ajayre/JacktheRipperBot/Documents/Renders/Toolhead-Exploded.png

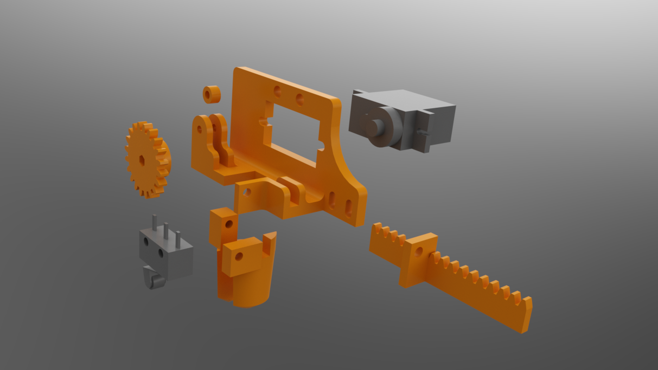
Documents/Renders/Toolhead-Exploded.png
