ajayre/JacktheRipperBot/Documents/Renders/Core-Exploded.png

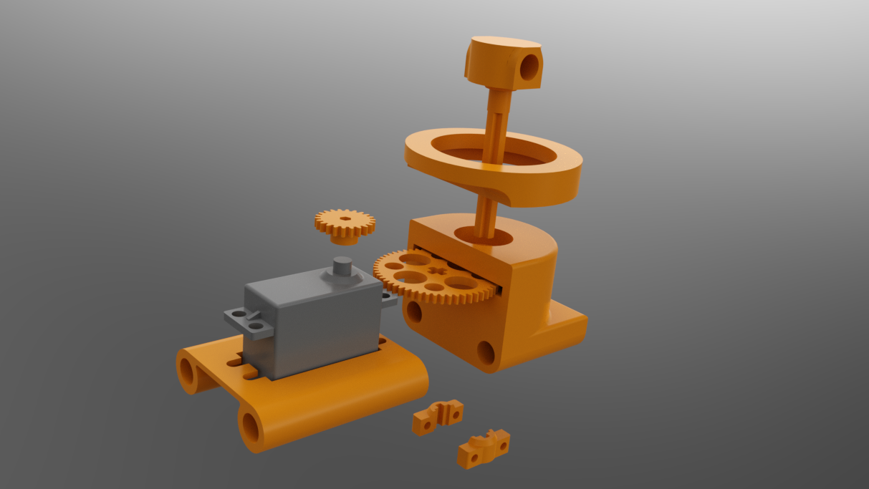
Documents/Renders/Core-Exploded.png
