ajayre/JacktheRipperBot/README.md

JackTheRipperBot
================

3D printable DVD ripping robot
