ajayre/JacktheRipperBot/Documents/BlockDiagram.png

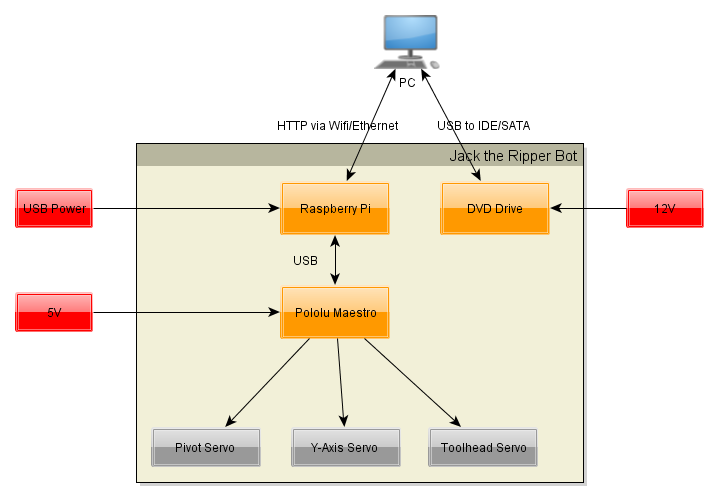
Documents/BlockDiagram.png
