ajayre/JacktheRipperBot/Documents/CircuitDiagram.png

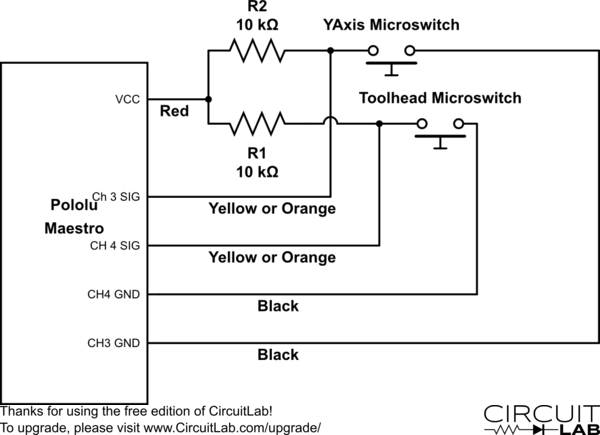
Documents/CircuitDiagram.png
