ajayre/JacktheRipperBot/Documents/MechanicsBlockDiagram.png

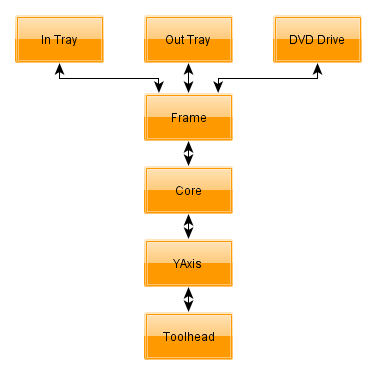
Documents/MechanicsBlockDiagram.png
