ajayre/JacktheRipperBot/Documents/Renders/Frame-Exploded.png

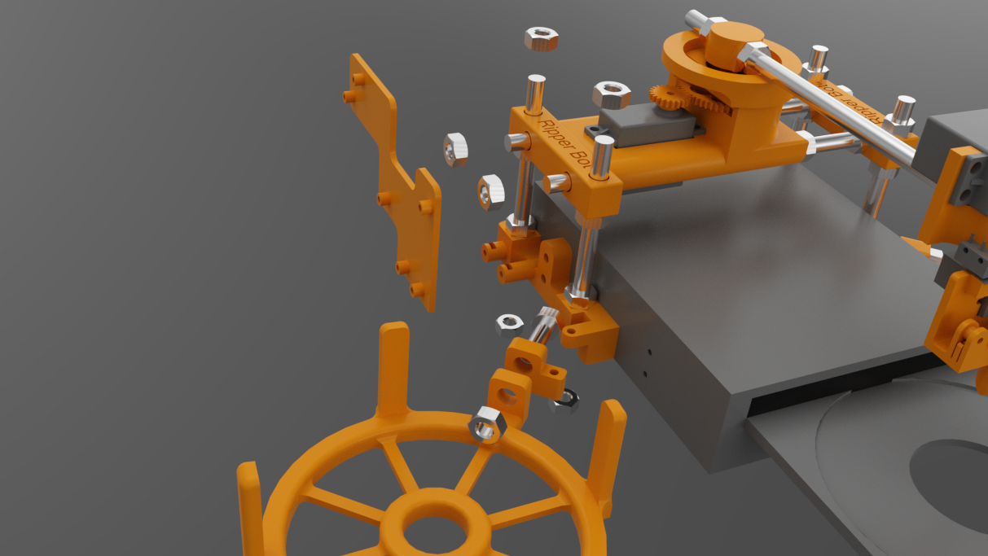
Documents/Renders/Frame-Exploded.png
