ajayre/JacktheRipperBot/Documents/Renders/JacktheRipperBot.png

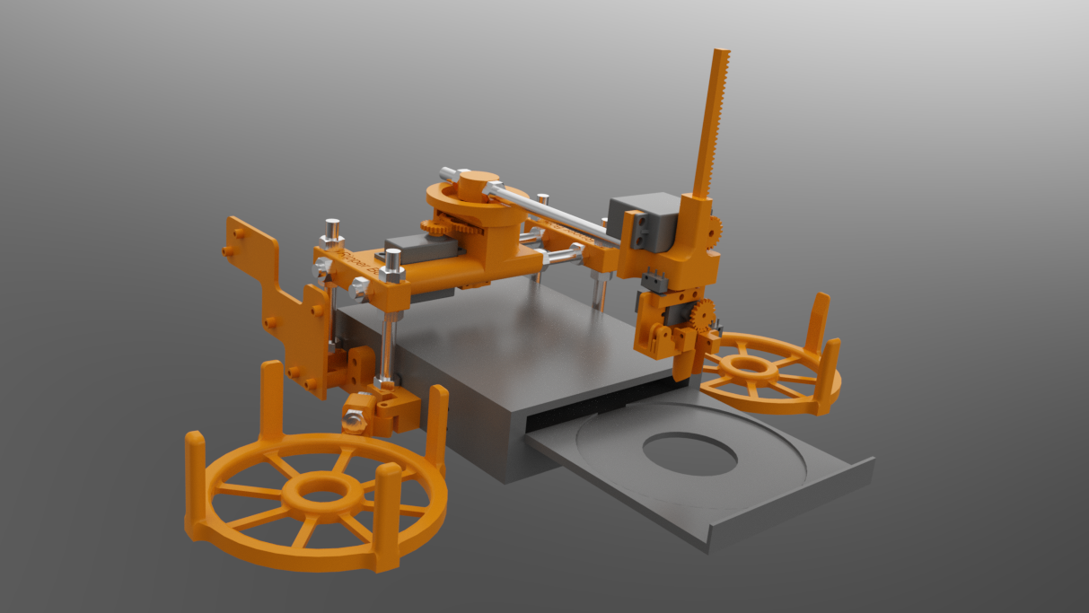
Documents/Renders/JacktheRipperBot.png
