ajayre/JacktheRipperBot/Documents/Renders/Tray-Exploded.png

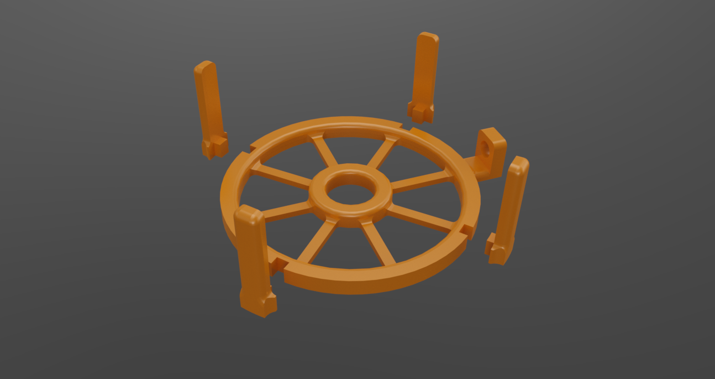
Documents/Renders/Tray-Exploded.png
