ajayre/JacktheRipperBot/Documents/Renders/YAxis-Exploded.png

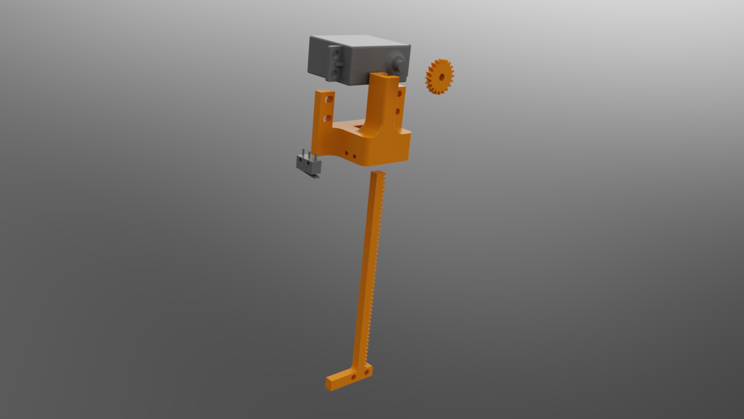
Documents/Renders/YAxis-Exploded.png
