ajayre/JacktheRipperBot/Documents/BillofMaterials.xlsx

Jack the Ripper Bot
Bill of Materials
Quantity | Description | Notes | Source2
1 | M8 threaded rod, 220mm long
2 | M8 threaded rod, 200mm long
4 | M8 threaded rod, 100mm long
2 | M8 threaded rod, 30mm long
32 | M8 nuts
27 | M8 lock nuts
1 | Futaba S3003 servo or equivalent | Modify for continuous rotation | http://www.techsupplies.co.uk/epages/Store.sf/en_GB/
1 | GWS S125 1T 2BB Sail Winch servo
1 | 9g minature servo |  | http://www.techsupplies.co.uk/epages/Store.sf/en_GB/
1 | Roller microswitch |  | http://www.rapidonline.com/Electronic-Components/Cherry-DG23-B1RA-Microswitch-SPST-On-On-50-2654
1 | Lever microswitch |  | http://www.rapidonline.com/Electronic-Components/Cherry-DG23-B1LA-Microswitch-SPST-On-On-50-2653
1 | Raspberry Pi Model B
1 | Pololu Maestro 6-channel servo controller |  | http://www.hobbytronics.co.uk/pololu-servo-controller-6
1 | 4GB+ SD card | For Raspberry Pi
1 | USB power cable | For Raspberry Pi
1 | DVD drive | Internal 5.25"
4 | Servo extension cables |  | http://www.ebay.co.uk/itm/280753277454?ssPageName=STRK:MEWNX:IT&_trksid=p3984.m1439.l2649
1 | USB cable | Connecting Maestro to Raspberry Pi
1 | Ethernet cable or N150 wifi adapter | Internet connectivity for Raspberry Pi | http://www.hobbytronics.co.uk/raspberry-pi/usb-wifi-adapter
1 | IDE/SATA to USB adapter | For the DVD drive | http://www.amazon.co.uk/dp/B004ND4632/ref=pe_385721_37038051_pe_217191_31005151_3p_M3T1_dp_1
2 | 608ZZ Bearing
18 | M3 nuts
11 | M2 nuts
4 | M3 socket cap, 12mm
14 | M3 socket cap, 14mm
2 | M3 socket cap, 16mm
2 | M3 socket cap, 18mm
7 | M2 socket cap, 10mm
4 | M2 socket cap, 14mm
8 | M3 washers
2 | 10kOhm resistor
1 | 0.1 inch crimp terminals
1 | 2 way 0.1 inch molex connector
1 | 2 pin PCB header
