ajayre/JacktheRipperBot/Parts/STEP/MainGear.stp

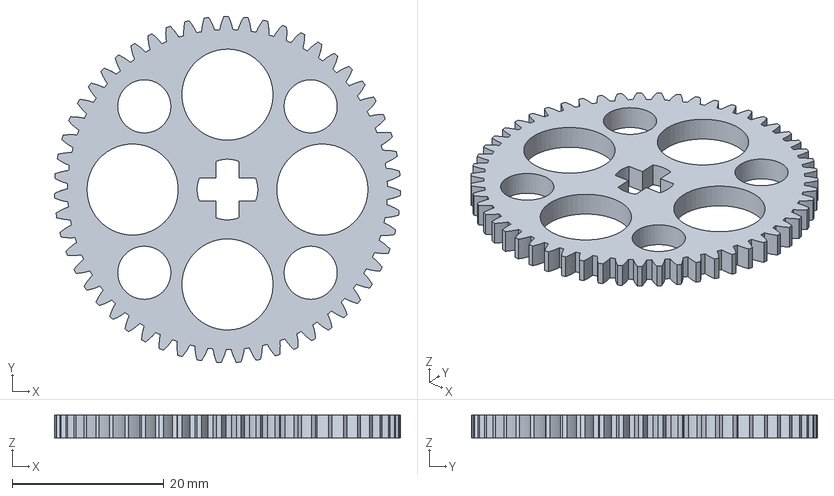
[picture p10: CAD file, 2013-10-11]
Parts/STEP/MainGear.stp
45.6 x 45.6 x 3.00 mm
