ajayre/JacktheRipperBot/Parts/STEP/YAxis-Servo.stp

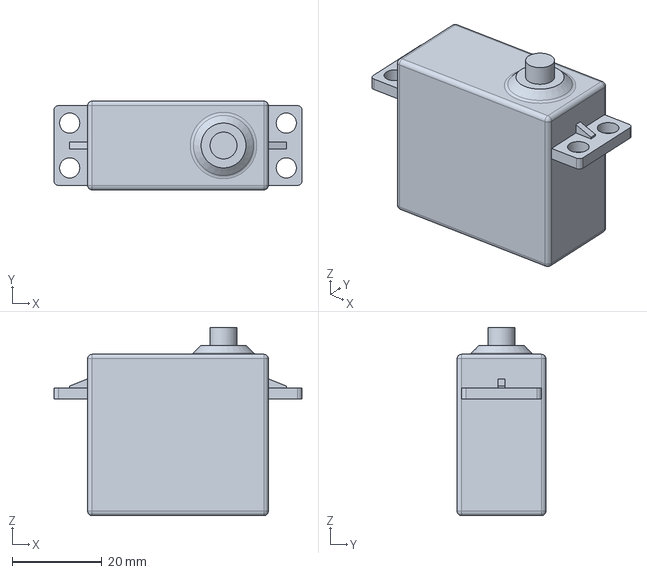
[picture p11: CAD file, 2016-06-15]
Parts/STEP/YAxis-Servo.stp
55.3 x 19.8 x 42.0 mm
