ajayre/JacktheRipperBot/Parts/STLs/JacktheRipperBot-OutTrayArm-1_X4.stl

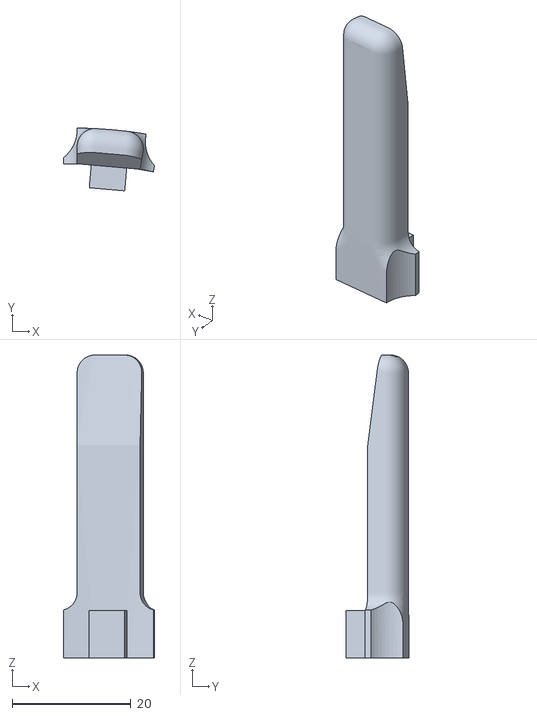
[picture p12: CAD file, 2013-09-24]
Parts/STLs/JacktheRipperBot-OutTrayArm-1_X4.stl
15.4 x 10.6 x 51.0
