ajayre/JacktheRipperBot/Parts/STEP/Toolhead-Microswitch.stp

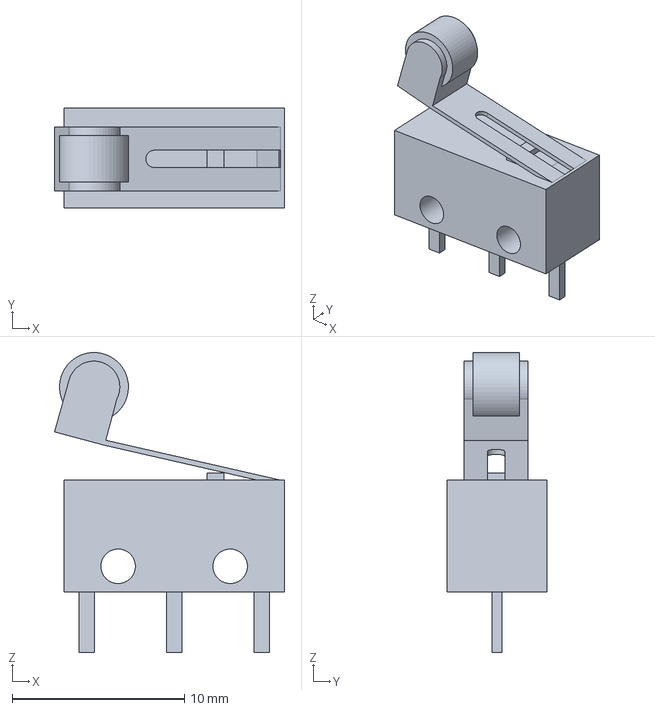
[picture p13: CAD file, 2016-06-15]
Parts/STEP/Toolhead-Microswitch.stp
13.3 x 5.80 x 17.4 mm
