ajayre/JacktheRipperBot/Parts/STLs/JacktheRipperBot-TrayBase-1_X2.stl

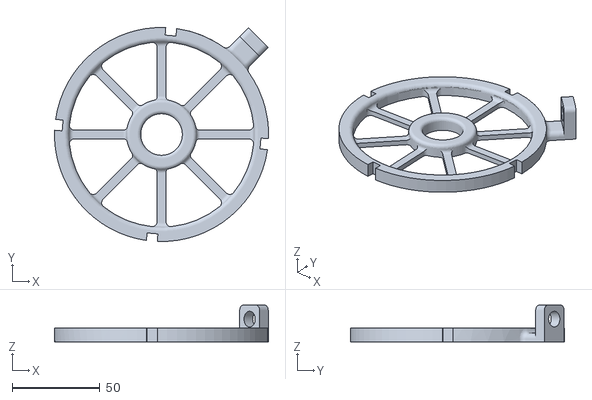
[picture p14: CAD file, 2013-09-24]
Parts/STLs/JacktheRipperBot-TrayBase-1_X2.stl
122.0 x 121.9 x 21.0
