ajayre/JacktheRipperBot/Parts/STEP/Drive.stp

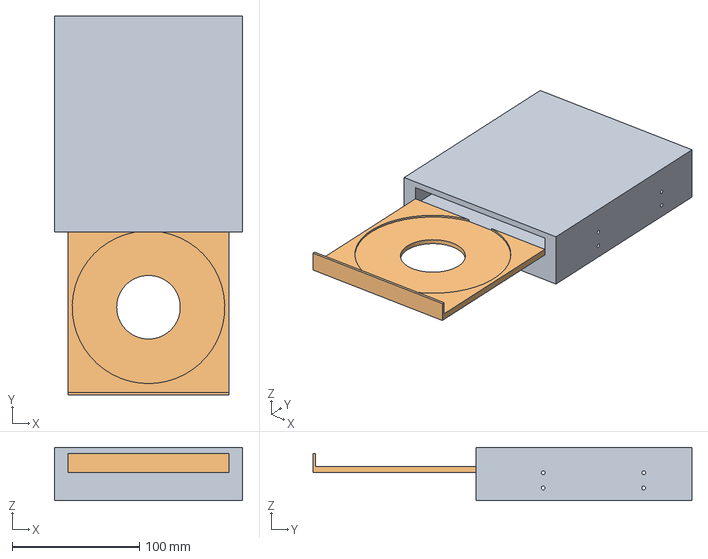
[picture p15: CAD file, 2016-06-15]
Parts/STEP/Drive.stp
148.2 x 298.0 x 42.0 mm
