ajayre/JacktheRipperBot/Parts/STLs/JacktheRipperBot-YAxis-1-YAxis-1.stl

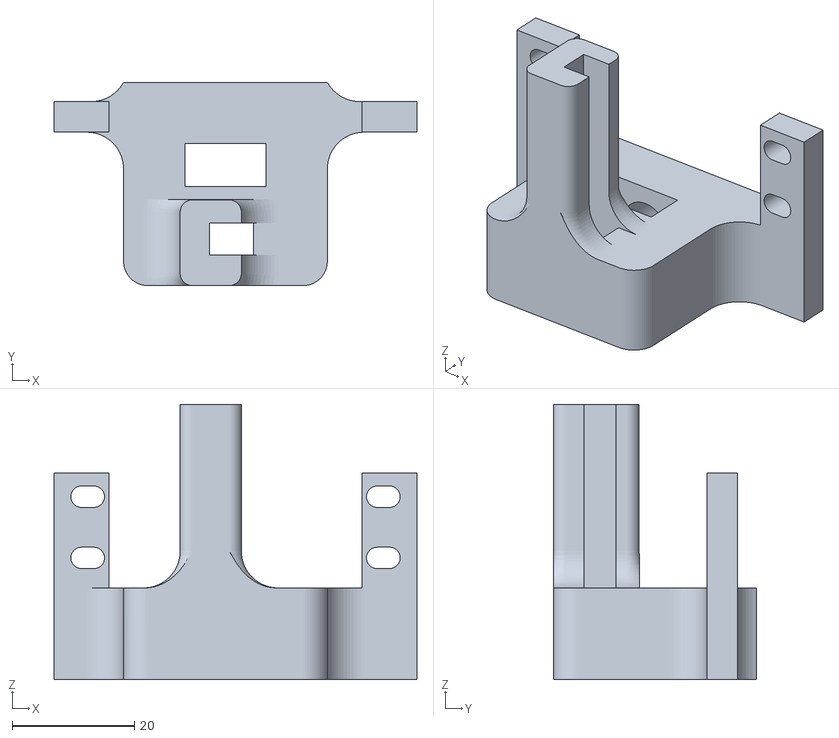
[picture p16: CAD file, 2013-09-20]
Parts/STLs/JacktheRipperBot-YAxis-1-YAxis-1.stl
59.3 x 33.2 x 45.0
