ajayre/JacktheRipperBot/Parts/STEP/Toolhead-Servo.stp

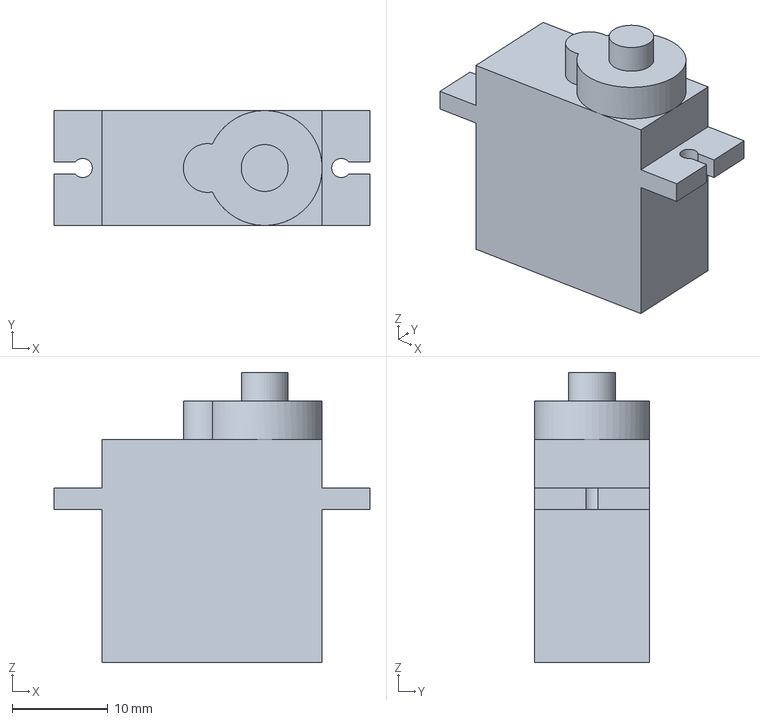
[picture p17: CAD file, 2016-06-15]
Parts/STEP/Toolhead-Servo.stp
33.0 x 12.0 x 30.3 mm
