ajayre/JacktheRipperBot/Parts/STLs/JacktheRipperBot-Core-1-Hub-1.stl

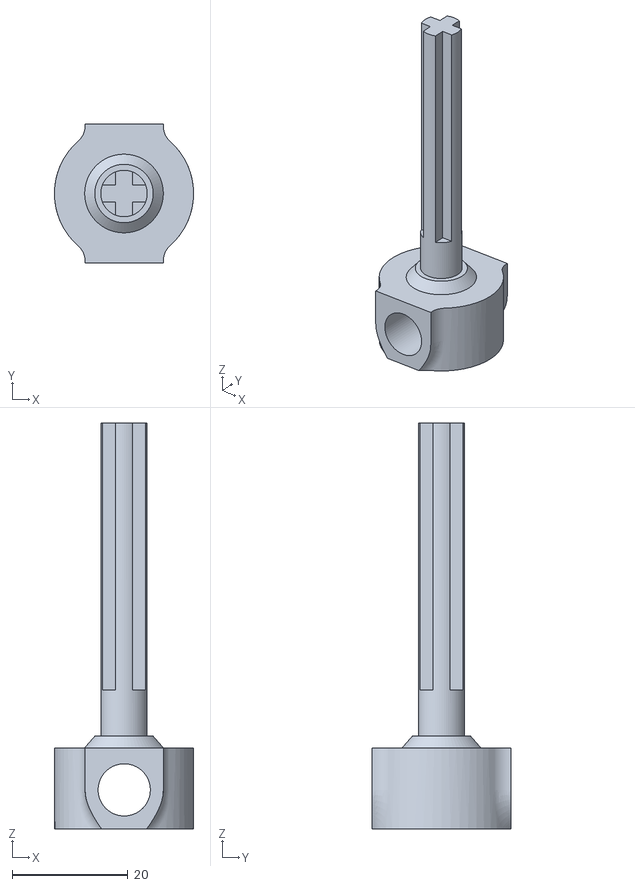
[picture p18: CAD file, 2013-09-07]
Parts/STLs/JacktheRipperBot-Core-1-Hub-1.stl
24.0 x 24.0 x 70.0
