ajayre/JacktheRipperBot/Parts/STEP/YAxis-Microswitch.stp

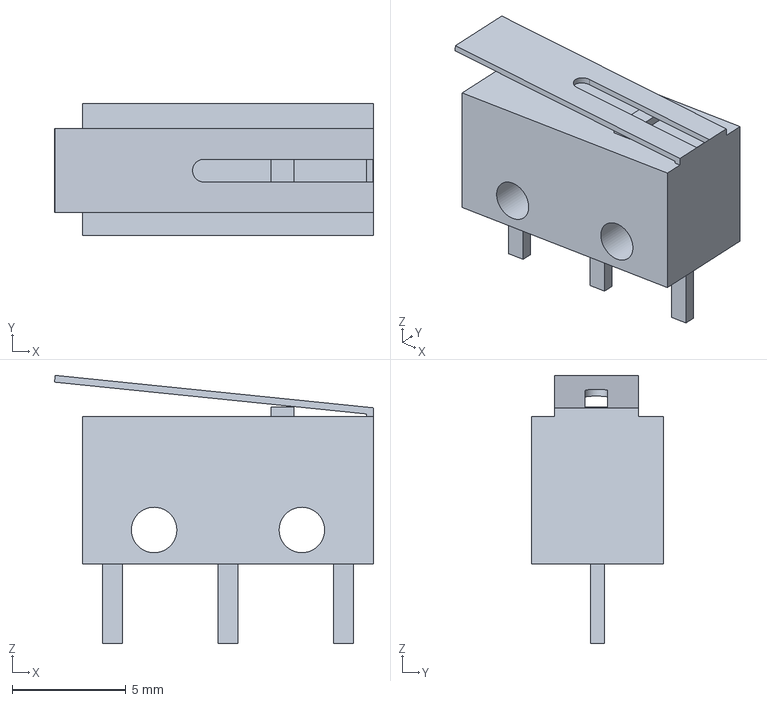
[picture p19: CAD file, 2016-06-15]
Parts/STEP/YAxis-Microswitch.stp
14.0 x 5.80 x 11.8 mm
