ajayre/JacktheRipperBot/Parts/STLs/JacktheRipperBot-Core-1-Retainer-1_X2.stl

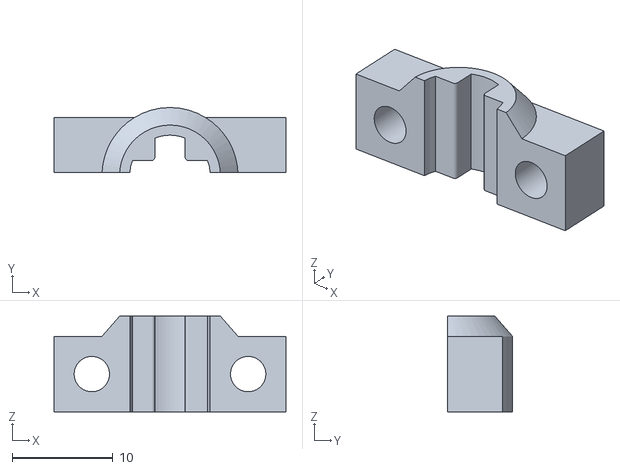
[picture p20: CAD file, 2013-09-07]
Parts/STLs/JacktheRipperBot-Core-1-Retainer-1_X2.stl
23.0 x 6.45 x 9.50
