ajayre/JacktheRipperBot/Parts/STLs/JacktheRipperBot-DriveBracketL-1.stl

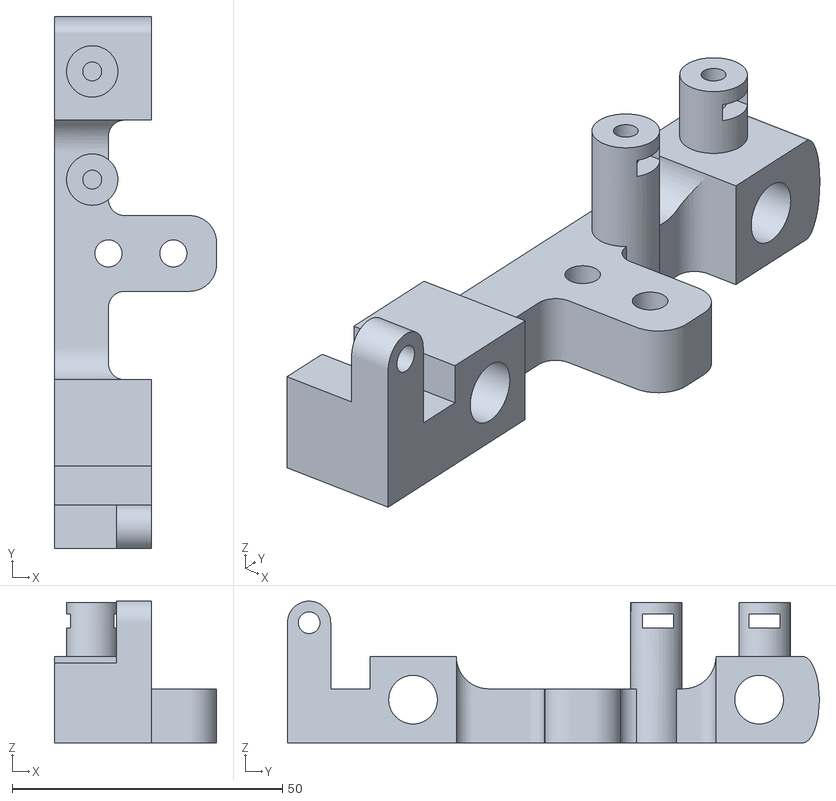
[picture p21: CAD file, 2013-09-01]
Parts/STLs/JacktheRipperBot-DriveBracketL-1.stl
30.0 x 98.4 x 26.2
