ajayre/JacktheRipperBot/Parts/STLs/JacktheRipperBot-TrayAnchor-1_X2.stl

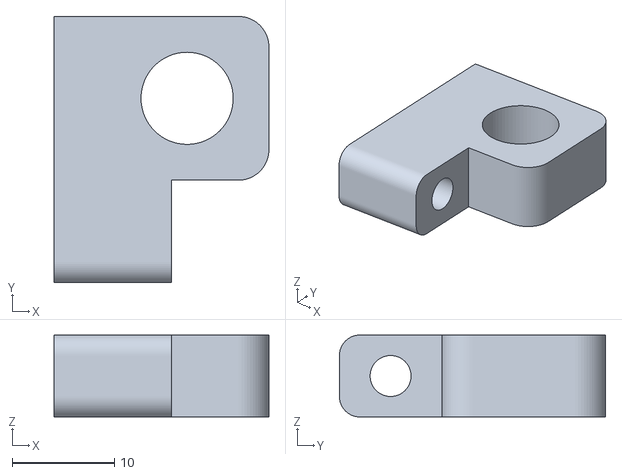
[picture p22: CAD file, 2013-09-01]
Parts/STLs/JacktheRipperBot-TrayAnchor-1_X2.stl
21.0 x 26.0 x 8.00
