ajayre/JacktheRipperBot/Parts/STEP/GripperMoving.stp

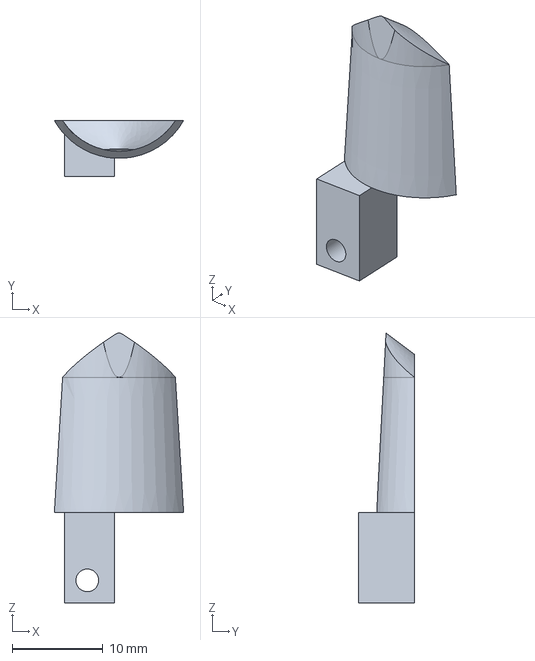
[picture p23: CAD file, 2013-10-11]
Parts/STEP/GripperMoving.stp
14.3 x 6.18 x 29.8 mm
