ajayre/JacktheRipperBot/Parts/STLs/JacktheRipperBot-Core-1-GearHousing-1.stl

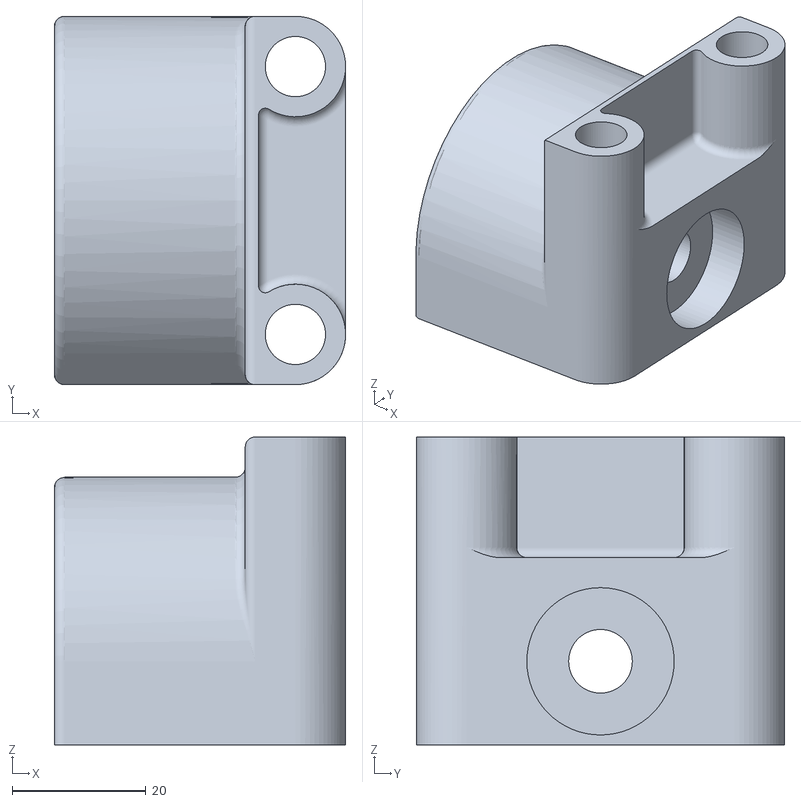
[picture p24: CAD file, 2013-09-01]
Parts/STLs/JacktheRipperBot-Core-1-GearHousing-1.stl
43.5 x 55.0 x 46.0
