ajayre/JacktheRipperBot/Parts/STLs/JacktheRipperBot-Toolhead-1-GripperFixed-1.stl

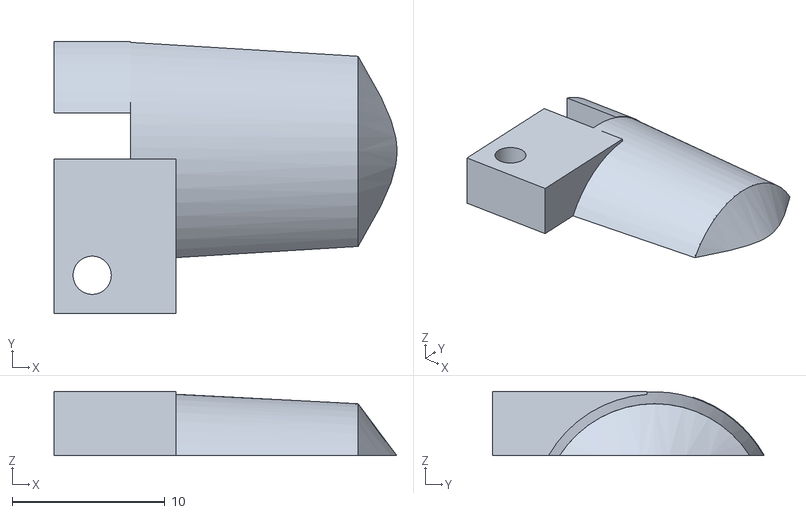
[picture p25: CAD file, 2013-09-01]
Parts/STLs/JacktheRipperBot-Toolhead-1-GripperFixed-1.stl
22.5 x 17.8 x 4.21
