ajayre/JacktheRipperBot/Parts/STEP/ElectronicsCaddy.stp

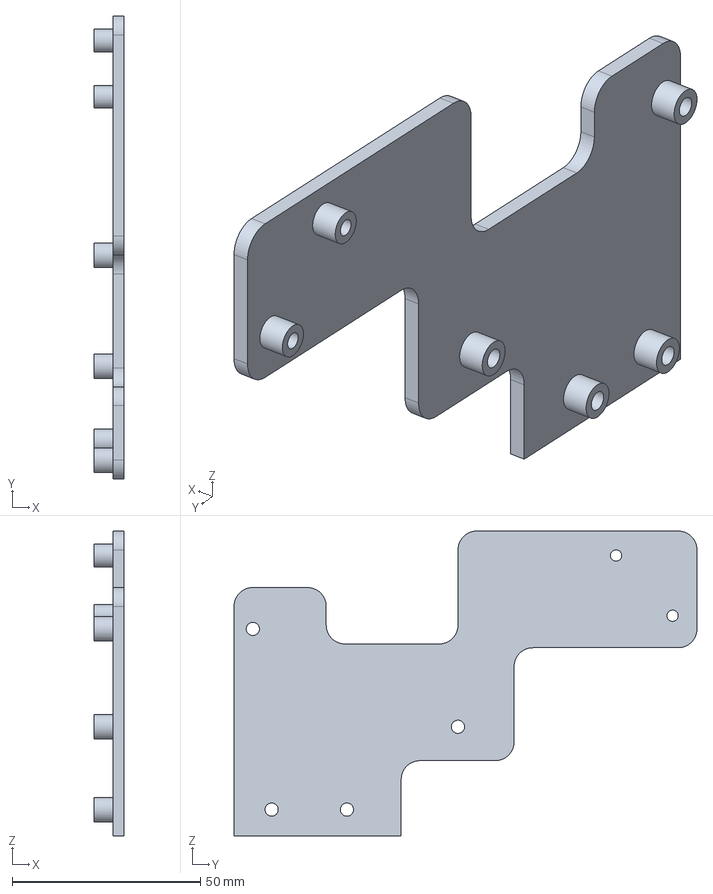
[picture p26: CAD file, 2013-10-11]
Parts/STEP/ElectronicsCaddy.stp
8.00 x 123.0 x 81.0 mm
