ajayre/JacktheRipperBot/Parts/STLs/JacktheRipperBot-YAxis-1-Rod-1.stl

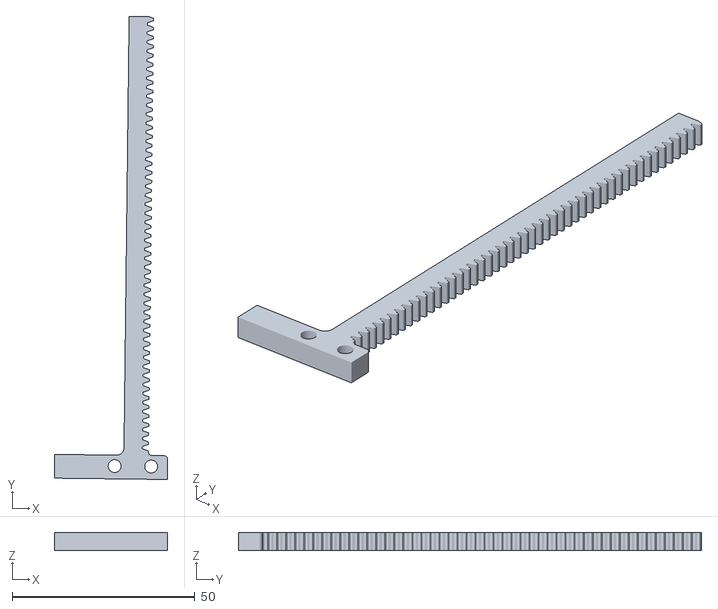
[picture p27: CAD file, 2013-09-01]
Parts/STLs/JacktheRipperBot-YAxis-1-Rod-1.stl
31.0 x 126.6 x 5.00
