ajayre/JacktheRipperBot/Parts/STEP/YAxis-ServoGear.stp

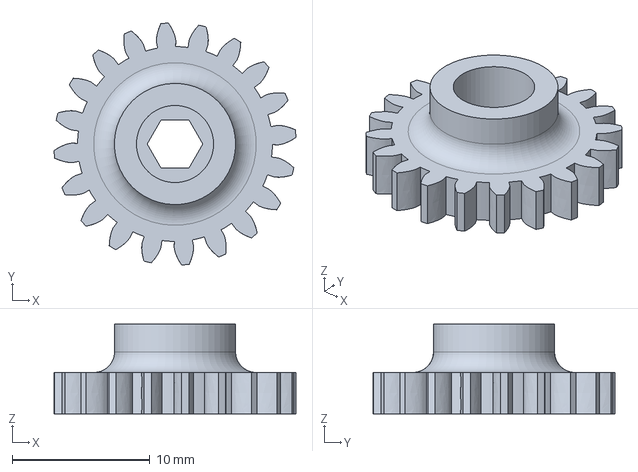
[picture p28: CAD file, 2013-10-11]
Parts/STEP/YAxis-ServoGear.stp
17.6 x 17.6 x 6.50 mm
