ajayre/JacktheRipperBot/Parts/STEP/Frame.stp

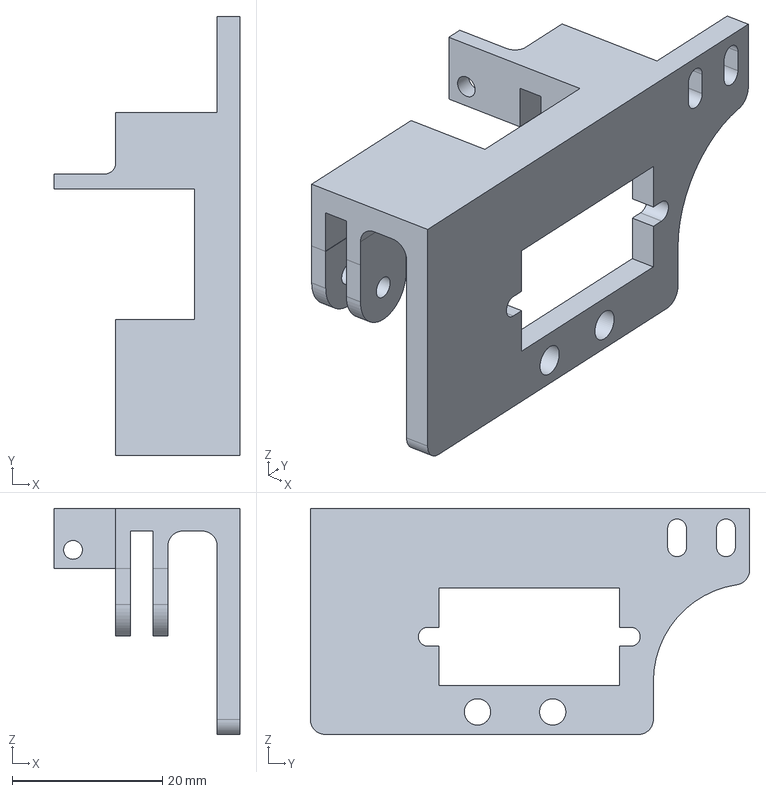
[picture p29: CAD file, 2013-10-11]
Parts/STEP/Frame.stp
24.7 x 58.4 x 30.0 mm
