ajayre/JacktheRipperBot/Parts/STLs/JacktheRipperBot-Toolhead-1-Guide-1.stl

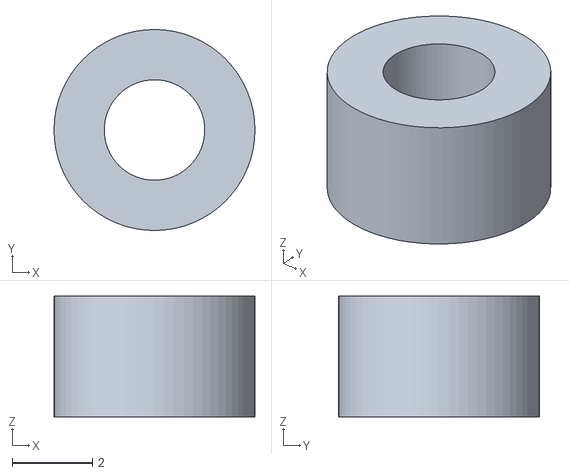
[picture p30: CAD file, 2013-09-01]
Parts/STLs/JacktheRipperBot-Toolhead-1-Guide-1.stl
5.00 x 5.00 x 3.00
