ajayre/JacktheRipperBot/Parts/STLs/JacktheRipperBot-Core-1-ServoBracket-1.stl

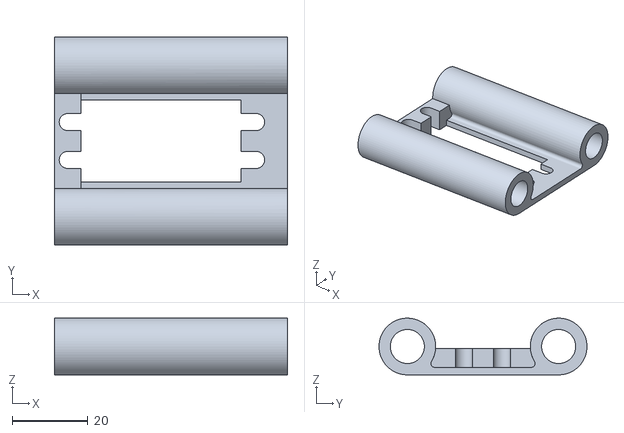
[picture p31: CAD file, 2013-09-01]
Parts/STLs/JacktheRipperBot-Core-1-ServoBracket-1.stl
61.6 x 55.0 x 15.0
