ajayre/JacktheRipperBot/Parts/STEP/DriveBracketR.stp

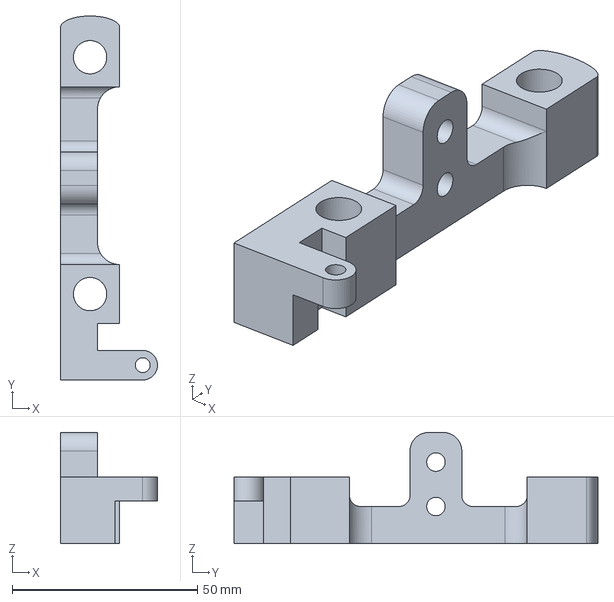
[picture p32: CAD file, 2013-10-11]
Parts/STEP/DriveBracketR.stp
26.2 x 98.3 x 30.0 mm
