ajayre/JacktheRipperBot/Parts/STLs/JacktheRipperBot-Core-1-SupportRing-1.stl

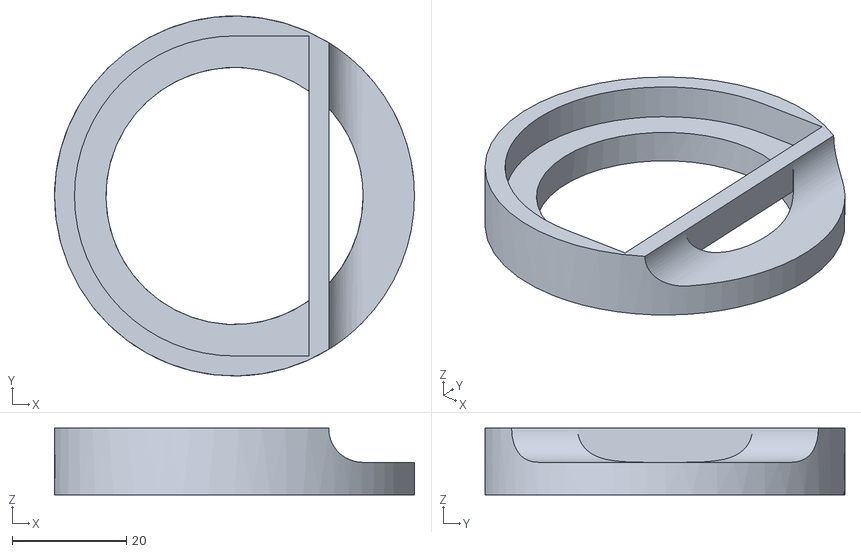
[picture p33: CAD file, 2013-09-01]
Parts/STLs/JacktheRipperBot-Core-1-SupportRing-1.stl
63.0 x 63.0 x 11.7
