ajayre/JacktheRipperBot/Parts/STLs/JacktheRipperBot-Corner-1_X2.stl

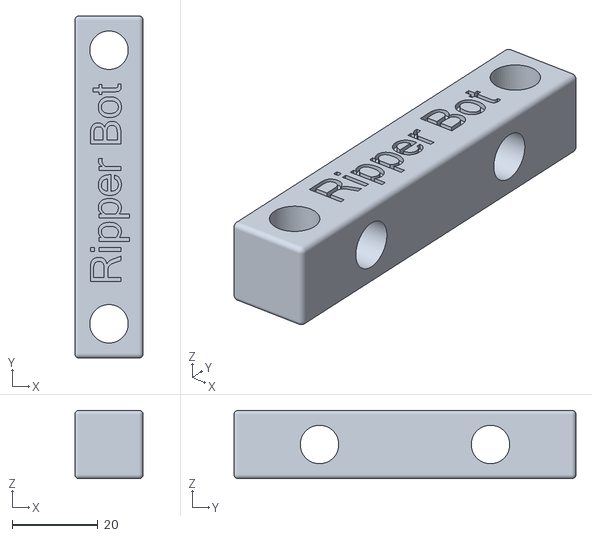
[picture p34: CAD file, 2013-09-01]
Parts/STLs/JacktheRipperBot-Corner-1_X2.stl
16.0 x 80.0 x 16.0
