ajayre/JacktheRipperBot/Parts/STLs/JacktheRipperBot-Toolhead-1-Rack-1.stl

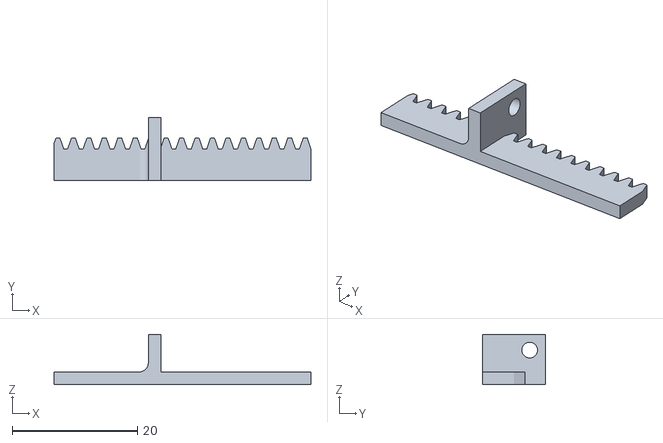
[picture p35: CAD file, 2013-09-01]
Parts/STLs/JacktheRipperBot-Toolhead-1-Rack-1.stl
41.0 x 10.0 x 8.00
