ajayre/JacktheRipperBot/Parts/STEP/Core-ServoGear.stp

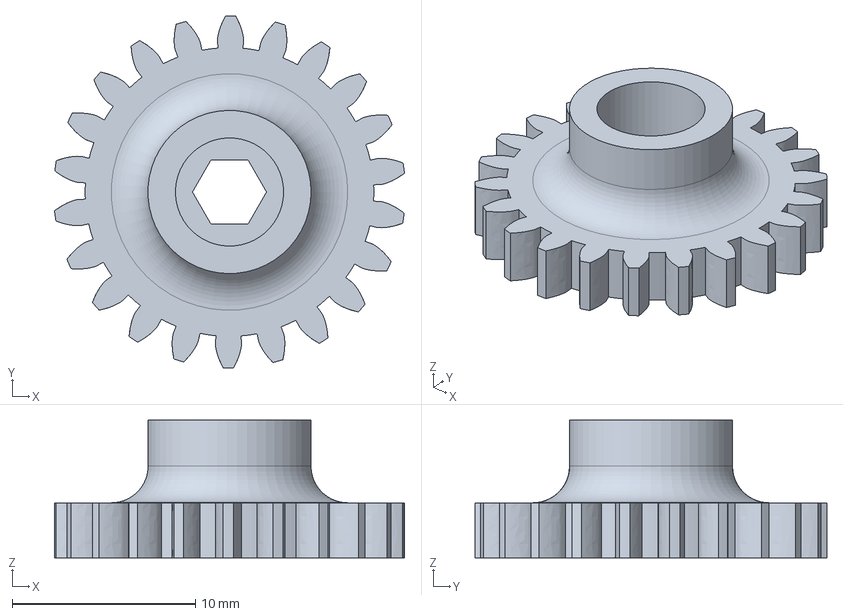
[picture p36: CAD file, 2013-10-11]
Parts/STEP/Core-ServoGear.stp
19.1 x 19.2 x 7.50 mm
