ajayre/JacktheRipperBot/Parts/STEP/Toolhead-ServoGear.stp

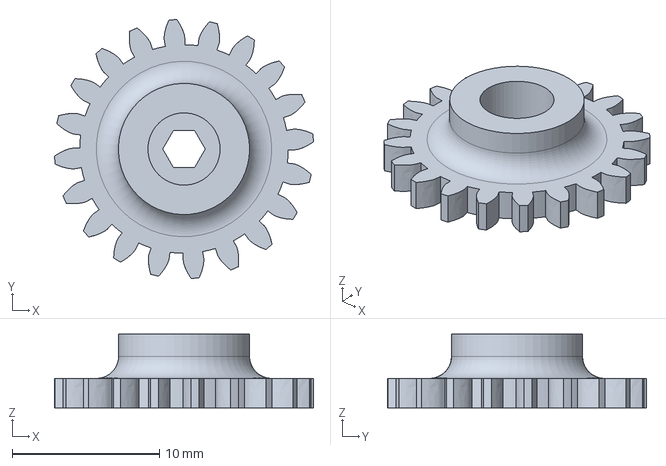
[picture p37: CAD file, 2013-10-11]
Parts/STEP/Toolhead-ServoGear.stp
17.6 x 17.6 x 5.00 mm
