ajayre/JacktheRipperBot/(list of files, cad)

Other CAD files:
Parts/STLs/JacktheRipperBot-Core-1-MainGear-1.stl
Parts/STEP/Core-Servo.stp
Parts/STLs/JacktheRipperBot-InTrayArm-1_X4.stl
Parts/STEP/YAxis.stp
Parts/STEP/TrayBase.stp
Parts/STEP/GearHousing.stp
Parts/STLs/JacktheRipperBot-Toolhead-1-GripperMoving-1.stl
Parts/STEP/Rod.stp
Parts/STEP/OutTrayArm.stp
Parts/STLs/JacktheRipperBot-YAxis-1-ServoGear-1.stl
Parts/STEP/Rack.stp
Parts/STLs/JacktheRipperBot-Toolhead-1-ServoGear-1.stl
Parts/STEP/Corner.stp
Parts/STLs/JacktheRipperBot-DriveBracketR-1.stl
Parts/STEP/Hub.stp
Parts/STLs/JacktheRipperBot-Toolhead-1-Frame-1.stl
Parts/STEP/Retainer.stp
Parts/STLs/JacktheRipperBot-ElectronicsCaddy-1.stl
Parts/STEP/ServoBracket.stp
Parts/STLs/JacktheRipperBot-Core-1-ServoGear-1.stl
Parts/STEP/DriveBracketL.stp
Parts/STEP/InTrayArm.stp
Parts/STEP/TrayAnchor.stp
Parts/STEP/GripperFixed.stp
Parts/STEP/Guide.stp
Parts/STEP/SupportRing.stp
