ajayre/JacktheRipperBot/(threads)

Thread 1 (2019-08-01):

Update 'BillofMaterials.xlsx'

dholtzmann, 2019-08-01:
Thanks for this project!

I am muddling my way through building this. I am preparing to buy the servos, controller, microswitches, and cables.

Most of the links are broken and many parts are discontinued.

Could you update the list of electronics? I am in the United States if that helps for electronics distributors.

Thanks

https://github.com/ajayre/JacktheRipperBot/blob/master/Documents/BillofMaterials.xlsx

ajayre, 2019-08-01:
It's been quite a few years since I last worked on the project so I don't
know of alternative sources. The microswitches are a standard size and the
servos are standardized also apart from the winch servo.

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

hypercube33, 2023-11-22:
ZF Electronics
Switch, Snap Action, SPDT, NO/NC, Roller Actr, Gold Plated Contact, 50mA, 30VDC, LA PCB
Manufacturer #: DG23-B3RA
RS Stock #: 70386228
-----------------
ZF Electronics
Switch, Snap Action, SPDT, NO/NC, Lever Actuator, Gold Plated Contact, 50mA, 30VDC, PCB
Manufacturer #: DG23-B1LA
RS Stock #: 70207657

You can find them both @ https://us.rs-online.com/

Cherry has discontinued the parts

#[dholtzmann](https://github.com/dholtzmann)
