ajayre/JacktheRipperBot/(commit log)

2013-07-31 Import of current parts. Work in progress.
2013-07-31 Working on toolhead.
2013-08-01 Removed old toolhead from top-level assembly.
2013-08-02 Completed first version of toolhead. Generated STLs.
    [Toolhead-Gripper-1.stl, Toolhead-Housing-1.stl, Toolhead-LinkRod-1.stl, Toolhead-Plate-1.stl, Toolhead-ServoBracket-1.stl, Toolhead-Slider-1.stl]
2013-08-05 New geared toolhead design.
    [Toolhead-Gripper-1.stl, Toolhead-Housing-1.stl, Toolhead-LinkRod-1.stl, Toolhead-Plate-1.stl, Toolhead-ServoBracket-1.stl, Toolhead-Slider-1.stl]
2013-08-06 Improvements to toolhead to use M3x12 bolts for pivots.
2013-08-07 Tweaks to grippers.
2013-08-07 Updated assembly to use new toolhead. Added M8 nuts and threaded rods. Started bill of materials.
    [BillofMaterials.xlsx]
2013-08-08 Updated BOM and core servo gear.
    [BillofMaterials.xlsx]
2013-08-08 Increased servo gear from 20 to 22 teeth and increased height by 1mm.
2013-08-11 Improvements to main gear, hub and grippers.
2013-08-15 New toolhead design.
2013-08-16 Tweak to servo flipper.
2013-08-16 Updates to server to support new toolhead design.
2013-08-17 Added mold for making toolhead cones from Sugru. Added support ring to core.
2013-08-18 New direst drive toolhead design.
2013-08-18 Updated server to support new toolhead design.
2013-08-19 Improvements to toolhead to better handle strain. Improved access to bolts holding microswitch to frame.
2013-08-20 Tweaks to support toolhead and better positioning.
2013-08-22 Tweaked gripper tips for better finding of DVD centers.
2013-08-25 Updated top-level assembly to contain current toolhead design. Added 3D PDF of complete design.
2013-08-30 Tweaked bottom of grippers.
2013-08-31 Added hub retainer to stop it rising up. Improved servo mount and removed spacers which are no longer needed. Updated rip batch file.
2013-09-01 Improved servo bracket that allows adjustment of gear meshing. Added troubleshooting list.
2013-09-01 Updated troubleshooting guide. Updated rip.bat. Added STLs - all rotated correctly for printing.
    [JacktheRipperBot-Core-1-GearHousing-1.stl, JacktheRipperBot-Core-1-Hub-1.stl, JacktheRipperBot-Core-1-MainGear-1.stl, JacktheRipperBot-Core-1-Retainer-1_X2.stl, JacktheRipperBot-Core-1-ServoBracket-1.stl, JacktheRipperBot-Core-1-ServoGear-1.stl, JacktheRipperBot-Core-1-SupportRing-1.stl, JacktheRipperBot-Corner-1_X2.stl]
2013-09-02 Updated bill of materials. Created list of what M2/M3 bolt are used where. Added more Ideas for Improvements. Colored hub retainer.
    [BillofMaterials.xlsx]
2013-09-02 Tweak to BOM.
    [BillofMaterials.xlsx]
2013-09-03 Updated BOM.
    [BillofMaterials.xlsx]
2013-09-04 Added circuit diagram. Updated BOM.
    [BillofMaterials.xlsx]
2013-09-07 Reduced size of bearing contact area so printed parts only touch the inner moving surface.
    [JacktheRipperBot-Core-1-Hub-1.stl, JacktheRipperBot-Core-1-Retainer-1_X2.stl]
2013-09-20 Fixed Y axis STL - was not aligned with XY plane.
    [JacktheRipperBot-YAxis-1-YAxis-1.stl]
2013-09-20 Separated tray arms from bases for faster printing.
2013-09-20 Improvements to tray arms to make them easier to print.
2013-09-23 Make slots on tray base slightly smaller.
2013-09-24 Generated STLs for new tray parts.
    [JacktheRipperBot-InTrayArm-1_X4.stl, JacktheRipperBot-OutTray-1.stl, JacktheRipperBot-OutTrayArm-1_X4.stl, JacktheRipperBot-TrayBase-1_X2.stl]
2013-10-11 Added STEP versions of parts.
    [Core-ServoGear.stp, Corner.stp, DriveBracketL.stp, DriveBracketR.stp, ElectronicsCaddy.stp, Frame.stp, GearHousing.stp, GripperFixed.stp]
2016-06-15 Added non-printable parts.
    [Core-Servo.stp, Drive.stp, Toolhead-Microswitch.stp, Toolhead-Servo.stp, YAxis-Microswitch.stp, YAxis-Servo.stp]
